Challmymind/anvil_pcb/(commit log)

2024-07-04 first fixes (board size and switch layout)
    [5pin_version.kicad_pcb, 5pin_version.kicad_sch, matrix.kicad_sch, mcu.kicad_sch, usb.kicad_sch]
2024-07-12 rewired most lines, changed sizes to make easier to solder
    [5pin_version.kicad_pcb, mcu.kicad_sch, usb.kicad_sch]
2024-07-14 completed re-routing
    [5pin_version.kicad_pcb, 5pin_version.kicad_sch, matrix.kicad_sch, mcu.kicad_sch]
2024-07-16 board completed
    [5pin_version.kicad_pcb, usb.kicad_sch]
